SR-Madsen/CocktailMachine/DiscoveryDemo/TouchGFX/assets/images/download1-removebg-preview.png

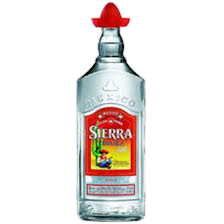
DiscoveryDemo/TouchGFX/assets/images/download1-removebg-preview.png
