SR-Madsen/CocktailMachine/DiscoveryDemo/TouchGFX/assets/images/download-removebg-preview.png

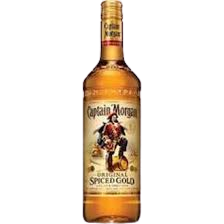
DiscoveryDemo/TouchGFX/assets/images/download-removebg-preview.png
