SR-Madsen/CocktailMachine/DiscoveryDemo/TouchGFX/assets/images/snapshotimagehandler_214572791-2-removebg-preview.png

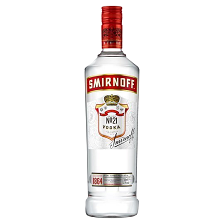
DiscoveryDemo/TouchGFX/assets/images/snapshotimagehandler_214572791-2-removebg-preview.png
