SR-Madsen/CocktailMachine/PCBV1/Powersupply.kicad_pcb

## KiCad design PCBV1/Powersupply.kicad_pcb (2021-08-30)

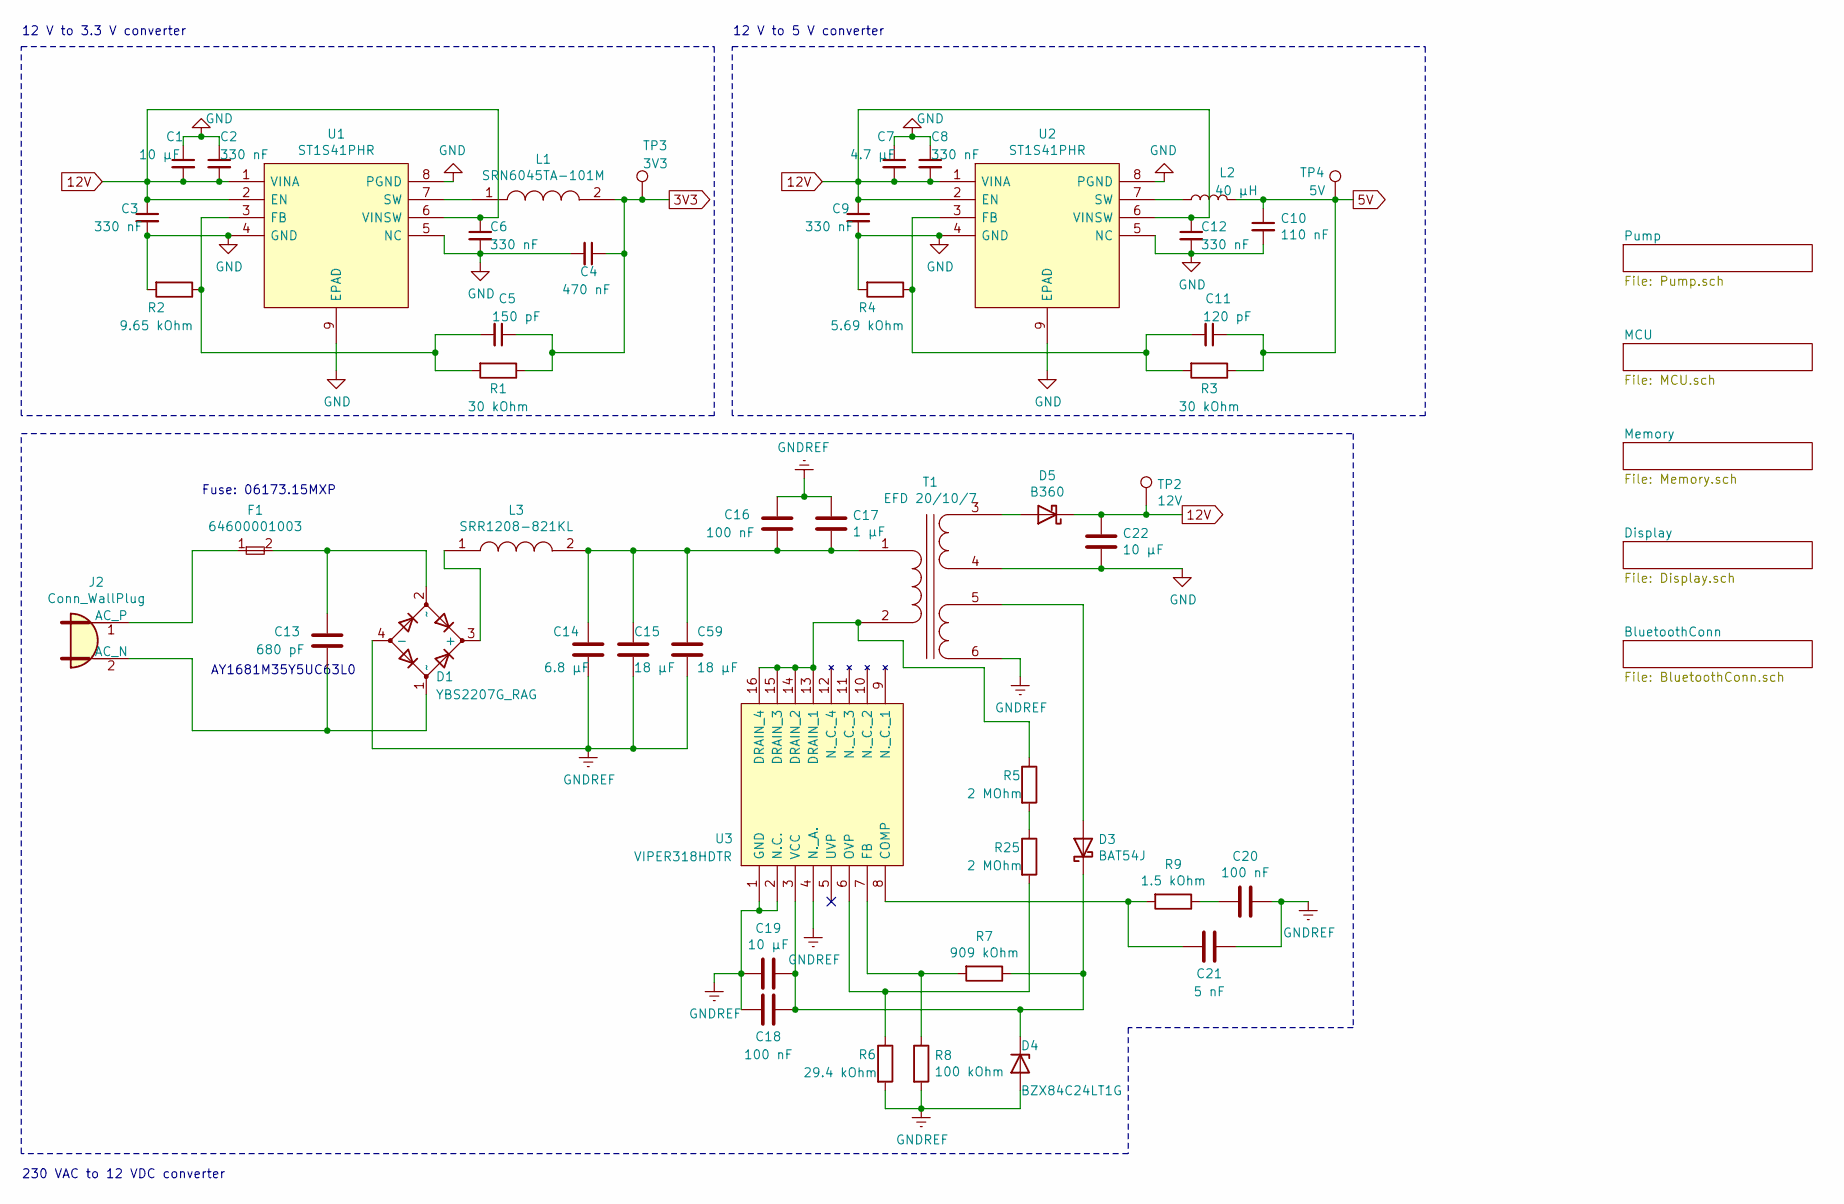
[picture p7: schematic Powersupply.sch, Cocktail Machine]

Parts:
C1, C19, C22: 10 µF; C_1206_3216Metric
C2, C3, C6, C8, C9, C12: 330 nF; C_0603_1608Metric
C4: 470 nF; C_0603_1608Metric
C5: 150 pF; C_0603_1608Metric
C7: 4.7 µF; C_0805_2012Metric
C10: 110 nF; C_0603_1608Metric
C11: 120 pF; C_0603_1608Metric
C13: 680 pF; C_Disc_D8.0mm_W5.0mm_P10.00mm
C14: 6.8 µF; CP_Radial_D10.0mm_P5.00mm
C15, C59: 18 µF; CP_Radial_D12.5mm_P5.00mm
C16: 100 nF; C_1210_3225Metric
C17: 1 µF; C_Rect_L24.0mm_W10.1mm_P22.50mm_MKT
C18, C20: 100 nF; C_0603_1608Metric
C21: 5 nF; C_0603_1608Metric
D1: YBS2207G_RAG; Mouser Part Number 821-YBS2207GRAG
D3: BAT54J; D_SOD-323F
D4: BZX84C24LT1G; D_SOT-23_ANK
D5: B360; D_SMC
F1: 64600001003; Mouser Part Number 576-64600001003
J2: Conn_WallPlug; PinHeader_1x02_P2.54mm_Vertical
L1: SRN6045TA-101M; Mouser Part Number 652-SRN6045TA-101M
L2: 40 µH; L_Bourns-SRN4018
L3: SRR1208-821KL; Mouser Part Number 652-SRR1208-821KL
R1, R3: 30 kOhm; R_0603_1608Metric
R2: 9.65 kOhm; R_0603_1608Metric
R4: 5.69 kOhm; R_0603_1608Metric
R5, R25: 2 MOhm; R_1206_3216Metric
R6: 29.4 kOhm; R_0603_1608Metric
R7: 909 kOhm; R_0603_1608Metric
R8: 100 kOhm; R_0603_1608Metric
R9: 1.5 kOhm; R_0603_1608Metric
T1: EFD 20/10/7; EFD_20_10_7
TP2: 12V; TestPoint_Pad_D2.0mm
TP3: 3V3; TestPoint_Pad_D2.0mm
TP4: 5V; TestPoint_Pad_D2.0mm
U1, U2: ST1S41PHR; Manufacturer_Part_Number ST1S41PHR
U3: VIPER318HDTR; Manufacturer_Part_Number VIPER318HDTR

Connections:
3V3: C4.1, C5.1, L1.2, R1.1, TP3.1; also elsewhere on the board
5V: C10.1, C11.1, L2.2, R3.1, TP4.1; also elsewhere on the board
12V: C1.2, C2.2, C3.1, C6.1, C7.2, C8.2, C9.1, C12.1, C22.1, D5.1 (K), TP2.1, U1.1 (VINA), U1.2 (EN), U1.6 (VINSW), U2.1 (VINA), U2.2 (EN), U2.6 (VINSW); also elsewhere on the board
GND: C1.1, C2.1, C3.2, C4.2, C6.2, C7.1, C8.1, C9.2, C10.2, C12.2, C22.2, R2.2, R4.2, T1.4 (SB), U1.4 (GND), U1.5 (NC), U1.8 (PGND), U1.9 (EPAD), U2.4 (GND), U2.5 (NC), U2.8 (PGND), U2.9 (EPAD); also elsewhere on the board
GNDREF: C14.2, C15.2, C16.1, C17.1, C18.2, C19.2, C20.1, C21.1, C59.2, D1.4 (-), D4.2 (A), R6.2, R8.2, T1.6 (SD), U3.1 (GND), U3.2 (N.C.), U3.4 (N._A.)
unnamed: C5.2, R1.2, R2.1, U1.3 (FB)
unnamed: C11.2, R3.2, R4.1, U2.3 (FB)
unnamed: C13.1, D1.2 (~~), F1.2
unnamed: C13.2, D1.1 (~~), J2.2 (AC_N)
unnamed: C14.1, C15.1, C16.2, C17.2, C59.1, L3.2, T1.1 (AA)
unnamed: C18.1, C19.1, D3.1 (K), D4.1 (K), R7.1, U3.3 (VCC)
unnamed: C20.2, R9.1
unnamed: C21.2, R9.2, U3.8 (COMP)
unnamed: D1.3 (+), L3.1
unnamed: D3.2 (A), T1.5 (SC)
unnamed: D5.2 (A), T1.3 (SA)
unnamed: F1.1, J2.1 (AC_P)
unnamed: L1.1, U1.7 (SW)
unnamed: L2.1, U2.7 (SW)
unnamed: R5.1, T1.2 (AB), U3.13 (DRAIN_1), U3.14 (DRAIN_2), U3.15 (DRAIN_3), U3.16 (DRAIN_4)
unnamed: R7.2, R8.1, U3.7 (FB)
unnamed: R5.2, R25.1
unnamed: R6.1, R25.2, U3.6 (OVP)

Notes on the sheet:
12 V to 3.3 V converter
12 V to 5 V converter
Fuse: 06173.15MXP
AY1681M35Y5UC63L0
230 VAC to 12 VDC converter

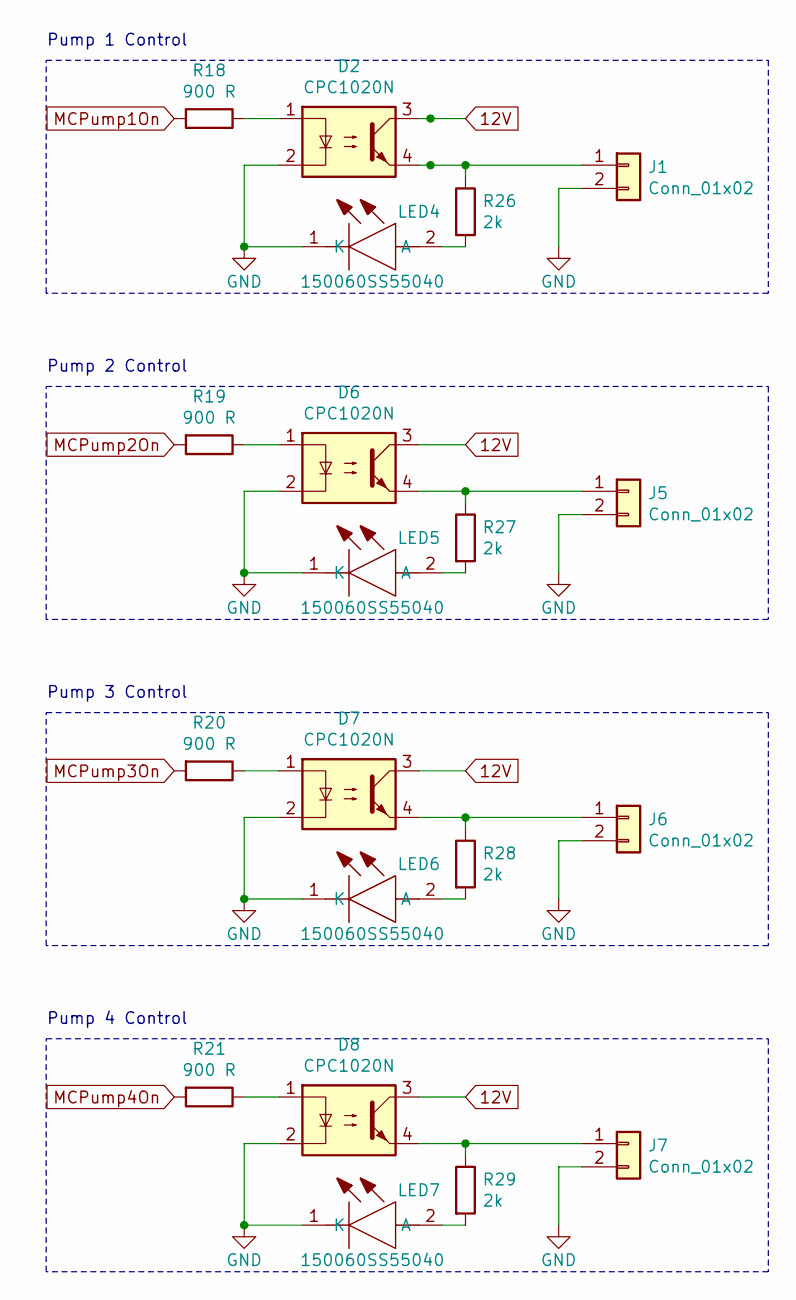
[picture p8: schematic Pump.sch, Cocktail Machine]

Parts:
D2, D6, D7, D8: CPC1020N; Mouser Part Number 849-CPC1020N
J1, J5, J6, J7: Conn_01x02; PinHeader_1x02_P2.54mm_Horizontal
LED4, LED5, LED6, LED7: 150060SS55040; Mouser Part Number 710-150060SS55040
R18, R19, R20, R21: 900 R; R_0603_1608Metric
R26, R27, R28, R29: 2k; R_0603_1608Metric

Connections:
12V: D2.3, D6.3, D7.3, D8.3; also elsewhere on the board
GND: D2.2, D6.2, D7.2, D8.2, J1.2, J5.2, J6.2, J7.2, LED4.1 (K), LED5.1 (K), LED6.1 (K), LED7.1 (K); also elsewhere on the board
MCPump1On: R18.2; also elsewhere on the board
MCPump2On: R19.2; also elsewhere on the board
MCPump3On: R20.2; also elsewhere on the board
MCPump4On: R21.2; also elsewhere on the board
unnamed: D2.1, R18.1
unnamed: D2.4, J1.1, R26.1
unnamed: D6.1, R19.1
unnamed: D6.4, J5.1, R27.1
unnamed: D7.1, R20.1
unnamed: D7.4, J6.1, R28.1
unnamed: D8.1, R21.1
unnamed: D8.4, J7.1, R29.1
unnamed: LED4.2 (A), R26.2
unnamed: LED5.2 (A), R27.2
unnamed: LED6.2 (A), R28.2
unnamed: LED7.2 (A), R29.2

Notes on the sheet:
Pump 1 Control
Pump 2 Control
Pump 3 Control
Pump 4 Control

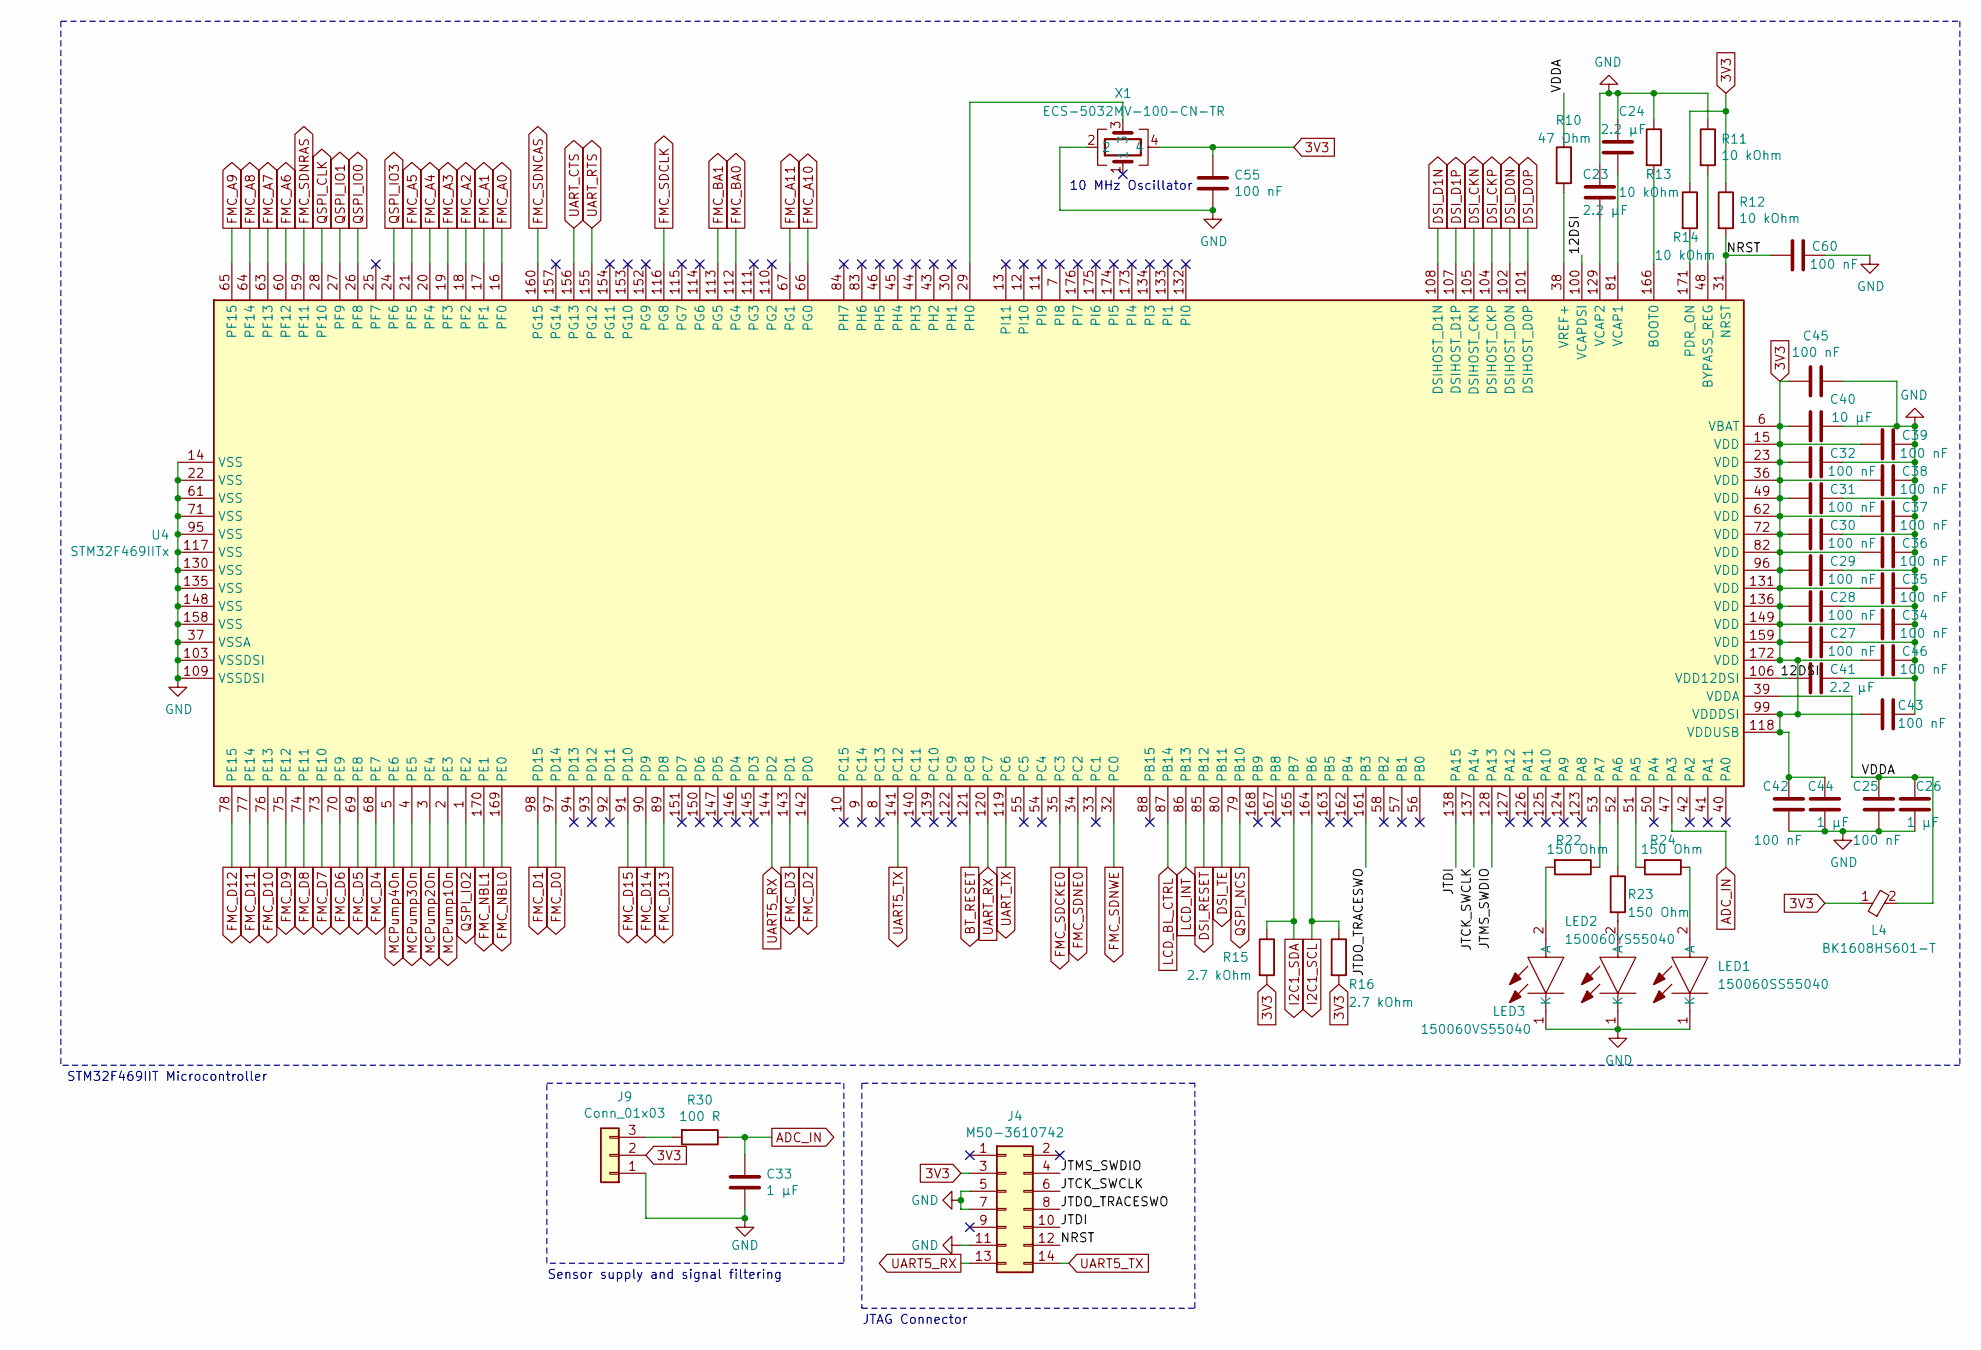
[picture p9: schematic MCU.sch, Cocktail Machine]

Parts:
C23, C24, C41: 2.2 µF; C_0603_1608Metric
C25, C27, C28, C29, C30, C31, C32, C34, C35, C36, C37, C38, C39, C42, C43, C45, C46, C55, C60: 100 nF; C_0603_1608Metric
C26, C33, C44: 1 µF; C_0603_1608Metric
C40: 10 µF; C_0603_1608Metric
J4: M50-3610742; M50-3610742R
J9: Conn_01x03; PinHeader_1x03_P2.54mm_Vertical
L4: BK1608HS601-T; Mouser Part Number 963-BK1608HS601-T
LED1: 150060SS55040; Mouser Part Number 710-150060SS55040
LED2: 150060YS55040; 150060VS55040; Mouser Part Number 710-150060YS55040
LED3: 150060VS55040; Mouser Part Number 710-150060VS55040
R10: 47 Ohm; R_0603_1608Metric
R11, R12, R13, R14: 10 kOhm; R_0603_1608Metric
R15, R16: 2.7 kOhm; R_0603_1608Metric
R22, R23, R24: 150 Ohm; R_0603_1608Metric
R30: 100 R; R_0603_1608Metric
U4: STM32F469IITx; LQFP-176_24x24mm_P0.5mm
X1: ECS-5032MV-100-CN-TR; ECS5032MV250CNTR; Mouser Part Number 520-5032MV-250-CNT

Connections:
3V3: C27.2, C28.2, C29.2, C30.2, C31.2, C32.2, C34.2, C35.2, C36.2, C37.2, C38.2, C39.2, C40.2, C42.1, C43.2, C44.1, C45.2, C46.1, C55.1, J4.3, J9.2, L4.1, R12.1, R14.1, R15.2, R16.2, U4.6 (VBAT), U4.15 (VDD), U4.23 (VDD), U4.36 (VDD), U4.49 (VDD), U4.62 (VDD), U4.72 (VDD), U4.82 (VDD), U4.96 (VDD), U4.99 (VDDDSI), U4.118 (VDDUSB), U4.131 (VDD), U4.136 (VDD), U4.149 (VDD), U4.159 (VDD), U4.172 (VDD), X1.4; also elsewhere on the board
/MCU/12DSI: C41.2, U4.100 (VCAPDSI), U4.106 (VDD12DSI)
/MCU/JTCK_SWCLK: J4.6, U4.137 (PA14)
/MCU/JTDI: J4.10, U4.138 (PA15)
/MCU/JTDO_TRACESWO: J4.8, U4.161 (PB3)
/MCU/JTMS_SWDIO: J4.4, U4.128 (PA13)
/MCU/NRST: C60.2, J4.12, R12.2, U4.31 (NRST)
/MCU/VDDA: C25.1, C26.1, L4.2, R10.1, U4.39 (VDDA)
ADC_IN: C33.1, R30.1, U4.47 (PA3)
BT_RESET: U4.121 (PC8); also elsewhere on the board
DSI_CKN: U4.105 (DSIHOST_CKN); also elsewhere on the board
DSI_CKP: U4.104 (DSIHOST_CKP); also elsewhere on the board
DSI_D0N: U4.102 (DSIHOST_D0N); also elsewhere on the board
DSI_D0P: U4.101 (DSIHOST_D0P); also elsewhere on the board
DSI_D1N: U4.108 (DSIHOST_D1N); also elsewhere on the board
DSI_D1P: U4.107 (DSIHOST_D1P); also elsewhere on the board
DSI_RESET: U4.85 (PB12); also elsewhere on the board
DSI_TE: U4.80 (PB11); also elsewhere on the board
FMC_A0: U4.16 (PF0); also elsewhere on the board
FMC_A1: U4.17 (PF1); also elsewhere on the board
FMC_A2: U4.18 (PF2); also elsewhere on the board
FMC_A3: U4.19 (PF3); also elsewhere on the board
FMC_A4: U4.20 (PF4); also elsewhere on the board
FMC_A5: U4.21 (PF5); also elsewhere on the board
FMC_A6: U4.60 (PF12); also elsewhere on the board
FMC_A7: U4.63 (PF13); also elsewhere on the board
FMC_A8: U4.64 (PF14); also elsewhere on the board
FMC_A9: U4.65 (PF15); also elsewhere on the board
FMC_A10: U4.66 (PG0); also elsewhere on the board
FMC_A11: U4.67 (PG1); also elsewhere on the board
FMC_BA0: U4.112 (PG4); also elsewhere on the board
FMC_BA1: U4.113 (PG5); also elsewhere on the board
FMC_D0: U4.97 (PD14); also elsewhere on the board
FMC_D1: U4.98 (PD15); also elsewhere on the board
FMC_D2: U4.142 (PD0); also elsewhere on the board
FMC_D3: U4.143 (PD1); also elsewhere on the board
FMC_D4: U4.68 (PE7); also elsewhere on the board
FMC_D5: U4.69 (PE8); also elsewhere on the board
FMC_D6: U4.70 (PE9); also elsewhere on the board
FMC_D7: U4.73 (PE10); also elsewhere on the board
FMC_D8: U4.74 (PE11); also elsewhere on the board
FMC_D9: U4.75 (PE12); also elsewhere on the board
FMC_D10: U4.76 (PE13); also elsewhere on the board
FMC_D11: U4.77 (PE14); also elsewhere on the board
FMC_D12: U4.78 (PE15); also elsewhere on the board
FMC_D13: U4.89 (PD8); also elsewhere on the board
FMC_D14: U4.90 (PD9); also elsewhere on the board
FMC_D15: U4.91 (PD10); also elsewhere on the board
FMC_NBL0: U4.169 (PE0); also elsewhere on the board
FMC_NBL1: U4.170 (PE1); also elsewhere on the board
FMC_SDCKE0: U4.35 (PC3); also elsewhere on the board
FMC_SDCLK: U4.116 (PG8); also elsewhere on the board
FMC_SDNCAS: U4.160 (PG15); also elsewhere on the board
FMC_SDNE0: U4.34 (PC2); also elsewhere on the board
FMC_SDNRAS: U4.59 (PF11); also elsewhere on the board
FMC_SDNWE: U4.32 (PC0); also elsewhere on the board
GND: C23.1, C24.1, C25.2, C26.2, C27.1, C28.1, C29.1, C30.1, C31.1, C32.1, C33.2, C34.1, C35.1, C36.1, C37.1, C38.1, C39.1, C40.1, C41.1, C42.2, C43.1, C44.2, C45.1, C46.2, C55.2, C60.1, J4.5, J4.7, J4.11, J9.1, LED1.1 (K), LED2.1 (K), LED3.1 (K), R11.1, R13.1, U4.14 (VSS), U4.22 (VSS), U4.37 (VSSA), U4.61 (VSS), U4.71 (VSS), U4.95 (VSS), U4.103 (VSSDSI), U4.109 (VSSDSI), U4.117 (VSS), U4.130 (VSS), U4.135 (VSS), U4.148 (VSS), U4.158 (VSS), X1.2; also elsewhere on the board
I2C1_SCL: R16.1, U4.164 (PB6); also elsewhere on the board
I2C1_SDA: R15.1, U4.165 (PB7); also elsewhere on the board
LCD_BL_CTRL: U4.87 (PB14); also elsewhere on the board
LCD_INT: U4.86 (PB13); also elsewhere on the board
MCPump1On: U4.2 (PE3); also elsewhere on the board
MCPump2On: U4.3 (PE4); also elsewhere on the board
MCPump3On: U4.4 (PE5); also elsewhere on the board
MCPump4On: U4.5 (PE6); also elsewhere on the board
unnamed: C23.2, U4.129 (VCAP2)
unnamed: C24.2, U4.81 (VCAP1)
unnamed: J9.3, R30.2
unnamed: LED1.2 (A), R24.1
unnamed: LED2.2 (A), R23.2
unnamed: LED3.2 (A), R22.2
unnamed: R10.2, U4.38 (VREF+)
unnamed: R11.2, U4.48 (BYPASS_REG)
unnamed: R13.2, U4.166 (BOOT0)
unnamed: R14.2, U4.171 (PDR_ON)
unnamed: R22.1, U4.53 (PA7)
unnamed: R23.1, U4.52 (PA6)
unnamed: R24.2, U4.51 (PA5)
unnamed: U4.29 (PH0), X1.3
QSPI_CLK: U4.28 (PF10); also elsewhere on the board
QSPI_IO0: U4.26 (PF8); also elsewhere on the board
QSPI_IO1: U4.27 (PF9); also elsewhere on the board
QSPI_IO2: U4.1 (PE2); also elsewhere on the board
QSPI_IO3: U4.24 (PF6); also elsewhere on the board
QSPI_NCS: U4.79 (PB10); also elsewhere on the board
UART5_RX: J4.13, U4.144 (PD2)
UART5_TX: J4.14, U4.141 (PC12)
UART_CTS: U4.156 (PG13); also elsewhere on the board
UART_RTS: U4.155 (PG12); also elsewhere on the board
UART_RX: U4.120 (PC7); also elsewhere on the board
UART_TX: U4.119 (PC6); also elsewhere on the board

Notes on the sheet:
JTAG Connector
STM32F469IIT Microcontroller
10 MHz Oscillator
Sensor supply and signal filtering

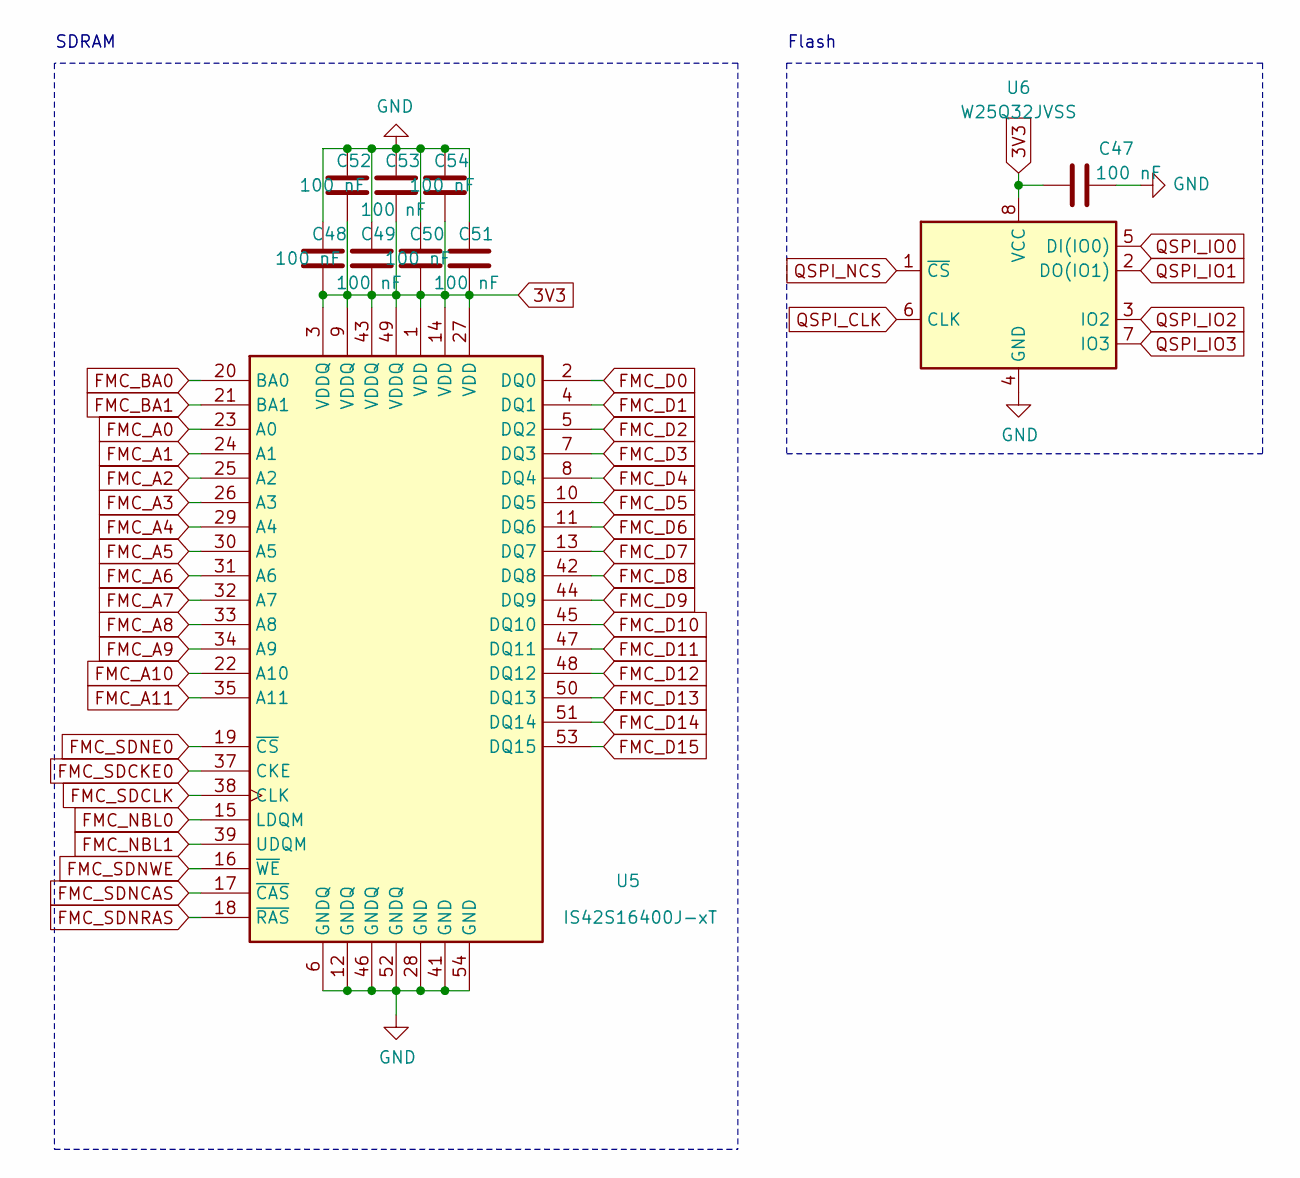
[picture p10: schematic Memory.sch, Cocktail Machine]

Parts:
C47, C48, C49, C50, C51, C52, C53, C54: 100 nF; C_0603_1608Metric
U5: IS42S16400J-xT; TSOP-II-54_22.2x10.16mm_P0.8mm
U6: W25Q32JVSS; SOIC-8_5.23x5.23mm_P1.27mm

Connections:
3V3: C47.2, C48.2, C49.2, C50.2, C51.2, C52.2, C53.2, C54.2, U5.1 (VDD), U5.3 (VDDQ), U5.9 (VDDQ), U5.14 (VDD), U5.27 (VDD), U5.43 (VDDQ), U5.49 (VDDQ), U6.8 (VCC); also elsewhere on the board
FMC_A0: U5.23 (A0); also elsewhere on the board
FMC_A1: U5.24 (A1); also elsewhere on the board
FMC_A2: U5.25 (A2); also elsewhere on the board
FMC_A3: U5.26 (A3); also elsewhere on the board
FMC_A4: U5.29 (A4); also elsewhere on the board
FMC_A5: U5.30 (A5); also elsewhere on the board
FMC_A6: U5.31 (A6); also elsewhere on the board
FMC_A7: U5.32 (A7); also elsewhere on the board
FMC_A8: U5.33 (A8); also elsewhere on the board
FMC_A9: U5.34 (A9); also elsewhere on the board
FMC_A10: U5.22 (A10); also elsewhere on the board
FMC_A11: U5.35 (A11); also elsewhere on the board
FMC_BA0: U5.20 (BA0); also elsewhere on the board
FMC_BA1: U5.21 (BA1); also elsewhere on the board
FMC_D0: U5.2 (DQ0); also elsewhere on the board
FMC_D1: U5.4 (DQ1); also elsewhere on the board
FMC_D2: U5.5 (DQ2); also elsewhere on the board
FMC_D3: U5.7 (DQ3); also elsewhere on the board
FMC_D4: U5.8 (DQ4); also elsewhere on the board
FMC_D5: U5.10 (DQ5); also elsewhere on the board
FMC_D6: U5.11 (DQ6); also elsewhere on the board
FMC_D7: U5.13 (DQ7); also elsewhere on the board
FMC_D8: U5.42 (DQ8); also elsewhere on the board
FMC_D9: U5.44 (DQ9); also elsewhere on the board
FMC_D10: U5.45 (DQ10); also elsewhere on the board
FMC_D11: U5.47 (DQ11); also elsewhere on the board
FMC_D12: U5.48 (DQ12); also elsewhere on the board
FMC_D13: U5.50 (DQ13); also elsewhere on the board
FMC_D14: U5.51 (DQ14); also elsewhere on the board
FMC_D15: U5.53 (DQ15); also elsewhere on the board
FMC_NBL0: U5.15 (LDQM); also elsewhere on the board
FMC_NBL1: U5.39 (UDQM); also elsewhere on the board
FMC_SDCKE0: U5.37 (CKE); also elsewhere on the board
FMC_SDCLK: U5.38 (CLK); also elsewhere on the board
FMC_SDNCAS: U5.17 (~CAS); also elsewhere on the board
FMC_SDNE0: U5.19 (~CS); also elsewhere on the board
FMC_SDNRAS: U5.18 (~RAS); also elsewhere on the board
FMC_SDNWE: U5.16 (~WE); also elsewhere on the board
GND: C47.1, C48.1, C49.1, C50.1, C51.1, C52.1, C53.1, C54.1, U5.6 (GNDQ), U5.12 (GNDQ), U5.28 (GND), U5.41 (GND), U5.46 (GNDQ), U5.52 (GNDQ), U5.54 (GND), U6.4 (GND); also elsewhere on the board
QSPI_CLK: U6.6 (CLK); also elsewhere on the board
QSPI_IO0: U6.5 (DI(IO0)); also elsewhere on the board
QSPI_IO1: U6.2 (DO(IO1)); also elsewhere on the board
QSPI_IO2: U6.3 (IO2); also elsewhere on the board
QSPI_IO3: U6.7 (IO3); also elsewhere on the board
QSPI_NCS: U6.1 (~CS); also elsewhere on the board

Notes on the sheet:
SDRAM
Flash

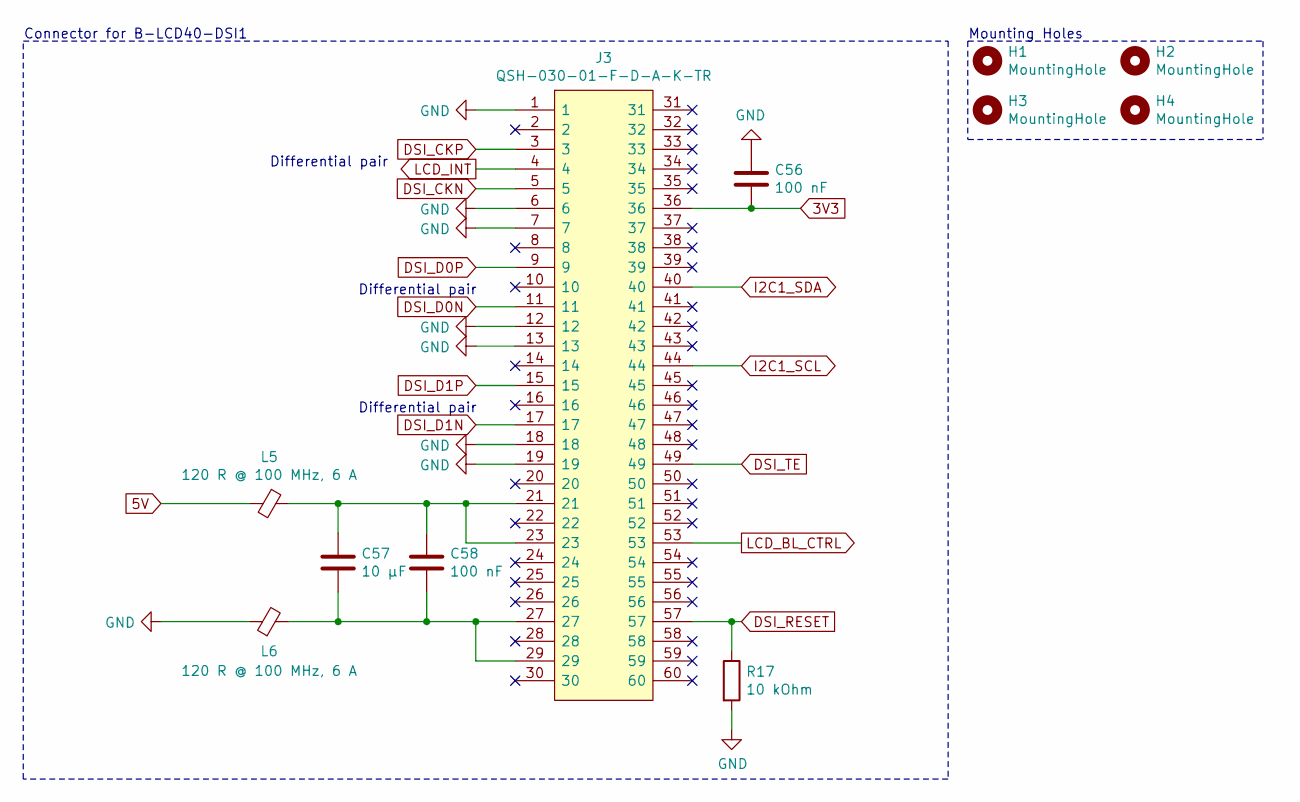
[picture p11: schematic Display.sch, Cocktail Machine]

Parts:
C56, C58: 100 nF; C_0603_1608Metric
C57: 10 µF; C_1206_3216Metric
H1, H2, H3, H4: MountingHole; MountingHole_6.4mm_M6_DIN965
J3: QSH-030-01-F-D-A-K-TR; QSH-030-01-F-D-A; Mouser Part Number 200-QSH03001FDAKTR
L5, L6: 120 R @ 100 MHz, 6 A; L_0805_2012Metric
R17: 10 kOhm; R_0603_1608Metric

Connections:
3V3: C56.2, J3.36; also elsewhere on the board
5V: L5.2; also elsewhere on the board
DSI_CKN: J3.5; also elsewhere on the board
DSI_CKP: J3.3; also elsewhere on the board
DSI_D0N: J3.11; also elsewhere on the board
DSI_D0P: J3.9; also elsewhere on the board
DSI_D1N: J3.17; also elsewhere on the board
DSI_D1P: J3.15; also elsewhere on the board
DSI_RESET: J3.57, R17.1; also elsewhere on the board
DSI_TE: J3.49; also elsewhere on the board
GND: C56.1, J3.1, J3.6, J3.7, J3.12, J3.13, J3.18, J3.19, L6.1, R17.2; also elsewhere on the board
I2C1_SCL: J3.44; also elsewhere on the board
I2C1_SDA: J3.40; also elsewhere on the board
LCD_BL_CTRL: J3.53; also elsewhere on the board
LCD_INT: J3.4; also elsewhere on the board
unnamed: C57.1, C58.1, J3.21, J3.23, L5.1
unnamed: C57.2, C58.2, J3.27, J3.29, L6.2

Notes on the sheet:
Connector for B-LCD40-DSI1
Mounting Holes
Differential pair

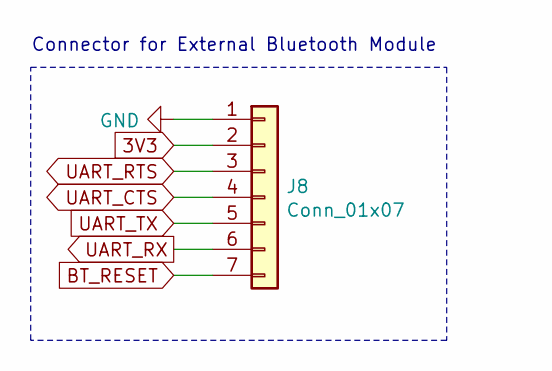
[picture p12: schematic BluetoothConn.sch, Cocktail Machine]

Parts:
J8: Conn_01x07; PinHeader_1x07_P2.54mm_Vertical

Connections:
3V3: J8.2; also elsewhere on the board
BT_RESET: J8.7; also elsewhere on the board
GND: J8.1; also elsewhere on the board
UART_CTS: J8.4; also elsewhere on the board
UART_RTS: J8.3; also elsewhere on the board
UART_RX: J8.6; also elsewhere on the board
UART_TX: J8.5; also elsewhere on the board

Notes on the sheet:
Connector for External Bluetooth Module

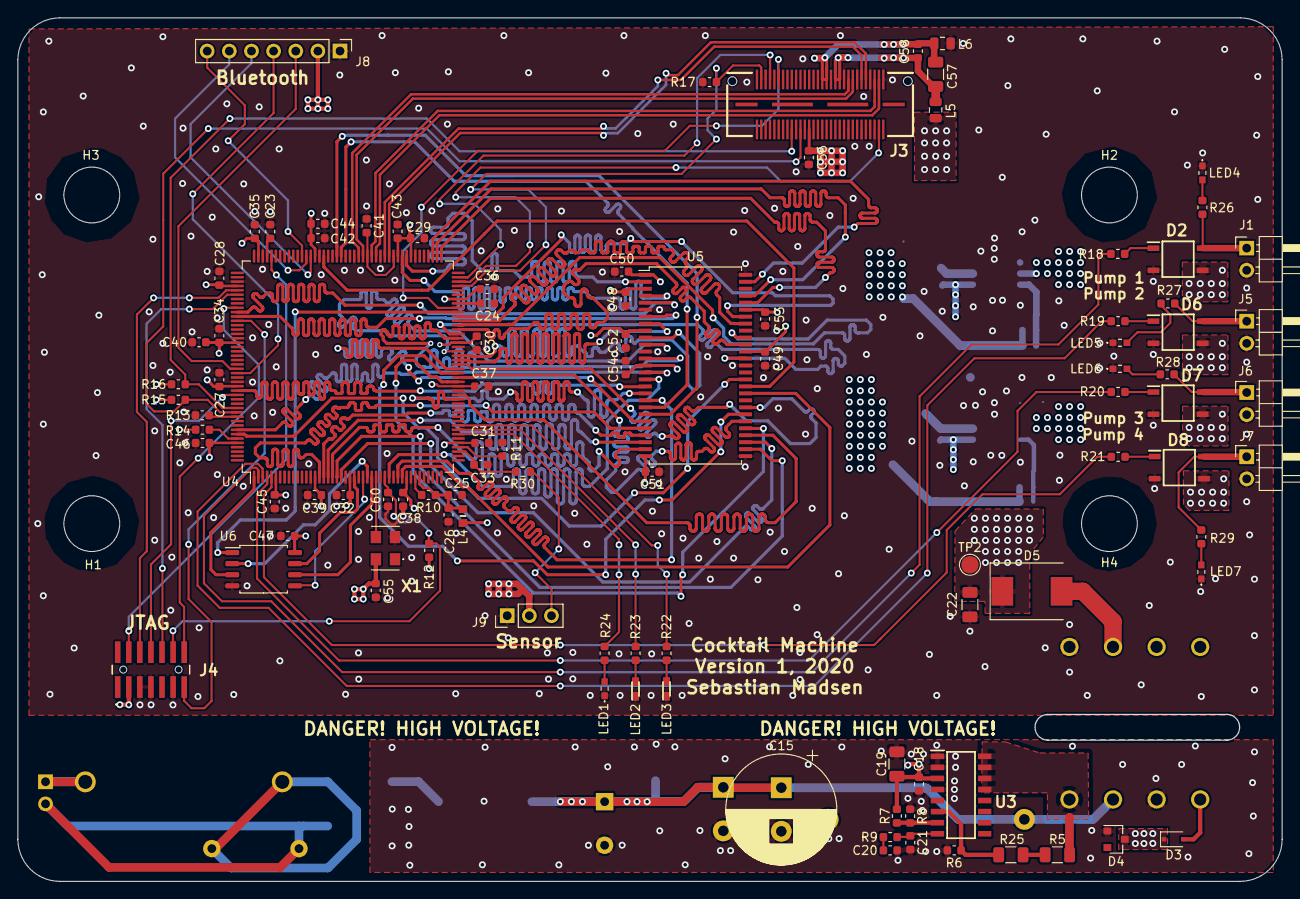
[picture p13: board Powersupply.kicad_pcb from above]

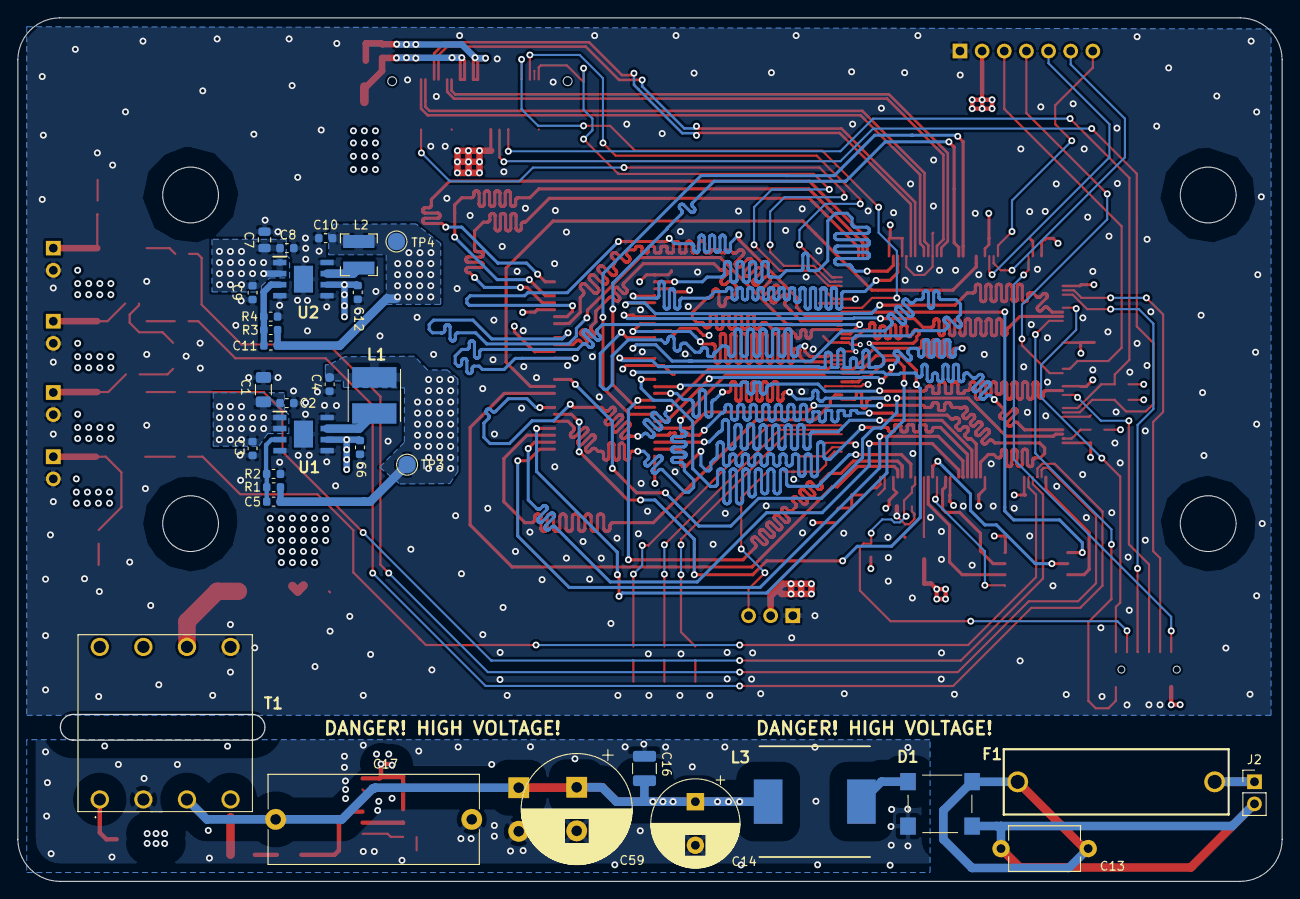
[picture p14: board Powersupply.kicad_pcb from below]

Board: 4 copper layers, 145.0 x 99.1 mm, 136 parts (32 on the bottom side), 126 nets.
