SR-Madsen/CocktailMachine/ConverterTest/ConverterTest.kicad_pcb

## KiCad design ConverterTest/ConverterTest.kicad_pcb (2020-10-31)

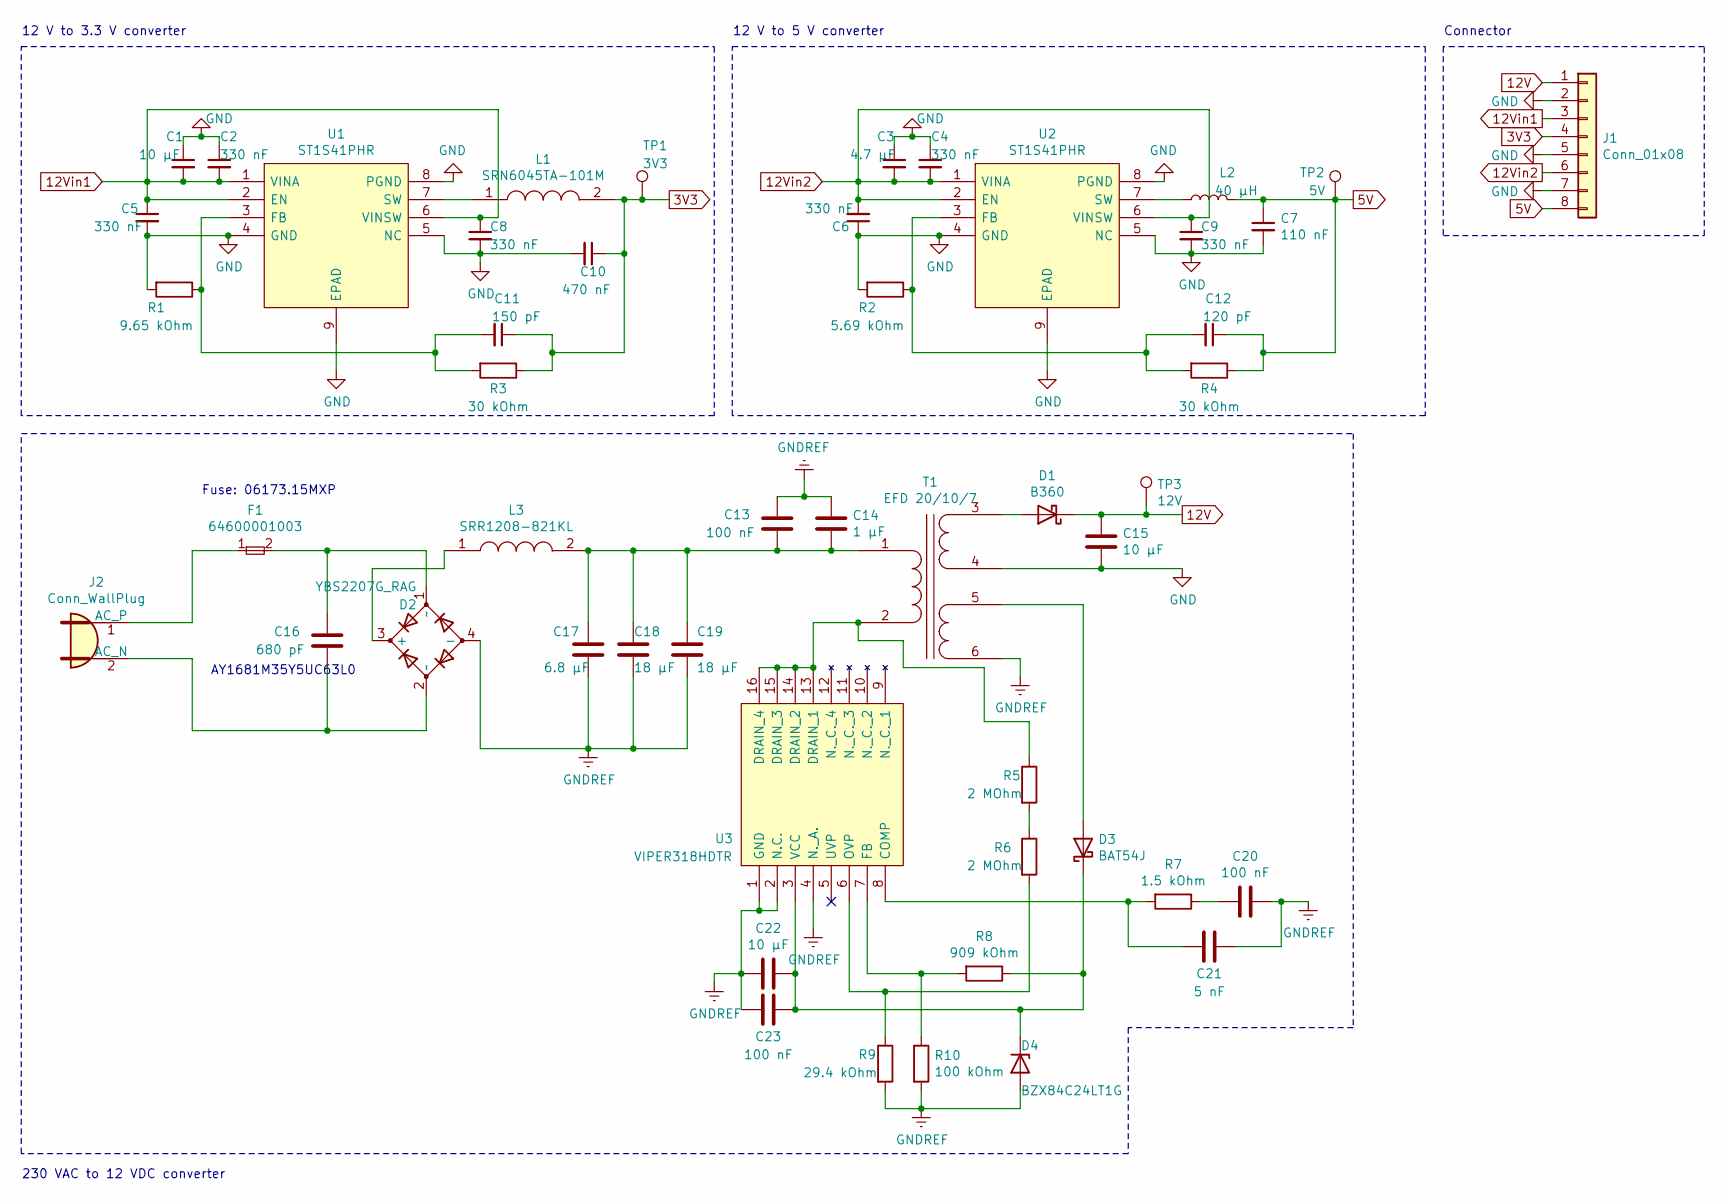
[picture p15: schematic ConverterTest.sch, Converter Tests]

Parts:
C1, C15, C22: 10 µF; C_1206_3216Metric
C2, C4, C5, C6, C8, C9: 330 nF; C_0603_1608Metric
C3: 4.7 µF; C_0805_2012Metric
C7: 110 nF; C_0603_1608Metric
C10: 470 nF; C_0603_1608Metric
C11: 150 pF; C_0603_1608Metric
C12: 120 pF; C_0603_1608Metric
C13: 100 nF; C_1210_3225Metric
C14: 1 µF; C_Rect_L24.0mm_W10.1mm_P22.50mm_MKT
C16: 680 pF; C_Disc_D8.0mm_W5.0mm_P10.00mm
C17: 6.8 µF; CP_Radial_D10.0mm_P5.00mm
C18, C19: 18 µF; CP_Radial_D12.5mm_P5.00mm
C20, C23: 100 nF; C_0603_1608Metric
C21: 5 nF; C_0603_1608Metric
D1: B360; D_SMC
D2: YBS2207G_RAG; Mouser Part Number 821-YBS2207GRAG
D3: BAT54J; D_SOD-323F
D4: BZX84C24LT1G; D_SOT-23_ANK
F1: 64600001003; Mouser Part Number 576-64600001003
J1: Conn_01x08; PinHeader_1x08_P2.54mm_Vertical
J2: Conn_WallPlug; PinHeader_1x02_P2.54mm_Vertical
L1: SRN6045TA-101M; Mouser Part Number 652-SRN6045TA-101M
L2: 40 µH; L_Bourns-SRN4018
L3: SRR1208-821KL; Mouser Part Number 652-SRR1208-821KL
R1: 9.65 kOhm; R_0603_1608Metric
R2: 5.69 kOhm; R_0603_1608Metric
R3, R4: 30 kOhm; R_0603_1608Metric
R5, R6: 2 MOhm; R_1206_3216Metric
R7: 1.5 kOhm; R_0603_1608Metric
R8: 909 kOhm; R_0603_1608Metric
R9: 29.4 kOhm; R_0603_1608Metric
R10: 100 kOhm; R_0603_1608Metric
T1: EFD 20/10/7; EFD_20_10_7
TP1: 3V3; TestPoint_Pad_D2.0mm
TP2: 5V; TestPoint_Pad_D2.0mm
TP3: 12V; TestPoint_Pad_D2.0mm
U1, U2: ST1S41PHR; Manufacturer_Part_Number ST1S41PHR
U3: VIPER318HDTR; Manufacturer_Part_Number VIPER318HDTR

Connections:
3V3: C10.1, C11.1, J1.4, L1.2, R3.1, TP1.1
5V: C7.1, C12.1, J1.8, L2.2, R4.1, TP2.1
12V: C15.1, D1.1 (K), J1.1, TP3.1
12Vin1: C1.2, C2.2, C5.1, C8.1, J1.3, U1.1 (VINA), U1.2 (EN), U1.6 (VINSW)
12Vin2: C3.2, C4.2, C6.2, C9.1, J1.6, U2.1 (VINA), U2.2 (EN), U2.6 (VINSW)
GND: C1.1, C2.1, C3.1, C4.1, C5.2, C6.1, C7.2, C8.2, C9.2, C10.2, C15.2, J1.2, J1.5, J1.7, R1.2, R2.2, T1.4 (SB), U1.4 (GND), U1.5 (NC), U1.8 (PGND), U1.9 (EPAD), U2.4 (GND), U2.5 (NC), U2.8 (PGND), U2.9 (EPAD)
GNDREF: C13.1, C14.1, C17.2, C18.2, C19.2, C20.1, C21.1, C22.2, C23.2, D2.4 (-), D4.2 (A), R9.2, R10.2, T1.6 (SD), U3.1 (GND), U3.2 (N.C.), U3.4 (N._A.)
unnamed: C11.2, R1.1, R3.2, U1.3 (FB)
unnamed: C12.2, R2.1, R4.2, U2.3 (FB)
unnamed: C13.2, C14.2, C17.1, C18.1, C19.1, L3.2, T1.1 (AA)
unnamed: C16.1, D2.1 (~~), F1.2
unnamed: C16.2, D2.2 (~~), J2.2 (AC_N)
unnamed: C20.2, R7.1
unnamed: C21.2, R7.2, U3.8 (COMP)
unnamed: C22.1, C23.1, D3.1 (K), D4.1 (K), R8.1, U3.3 (VCC)
unnamed: D1.2 (A), T1.3 (SA)
unnamed: D2.3 (+), L3.1
unnamed: D3.2 (A), T1.5 (SC)
unnamed: F1.1, J2.1 (AC_P)
unnamed: L1.1, U1.7 (SW)
unnamed: L2.1, U2.7 (SW)
unnamed: R5.1, T1.2 (AB), U3.13 (DRAIN_1), U3.14 (DRAIN_2), U3.15 (DRAIN_3), U3.16 (DRAIN_4)
unnamed: R5.2, R6.1
unnamed: R6.2, R9.1, U3.6 (OVP)
unnamed: R8.2, R10.1, U3.7 (FB)

Notes on the sheet:
12 V to 3.3 V converter
12 V to 5 V converter
Fuse: 06173.15MXP
AY1681M35Y5UC63L0
230 VAC to 12 VDC converter
Connector

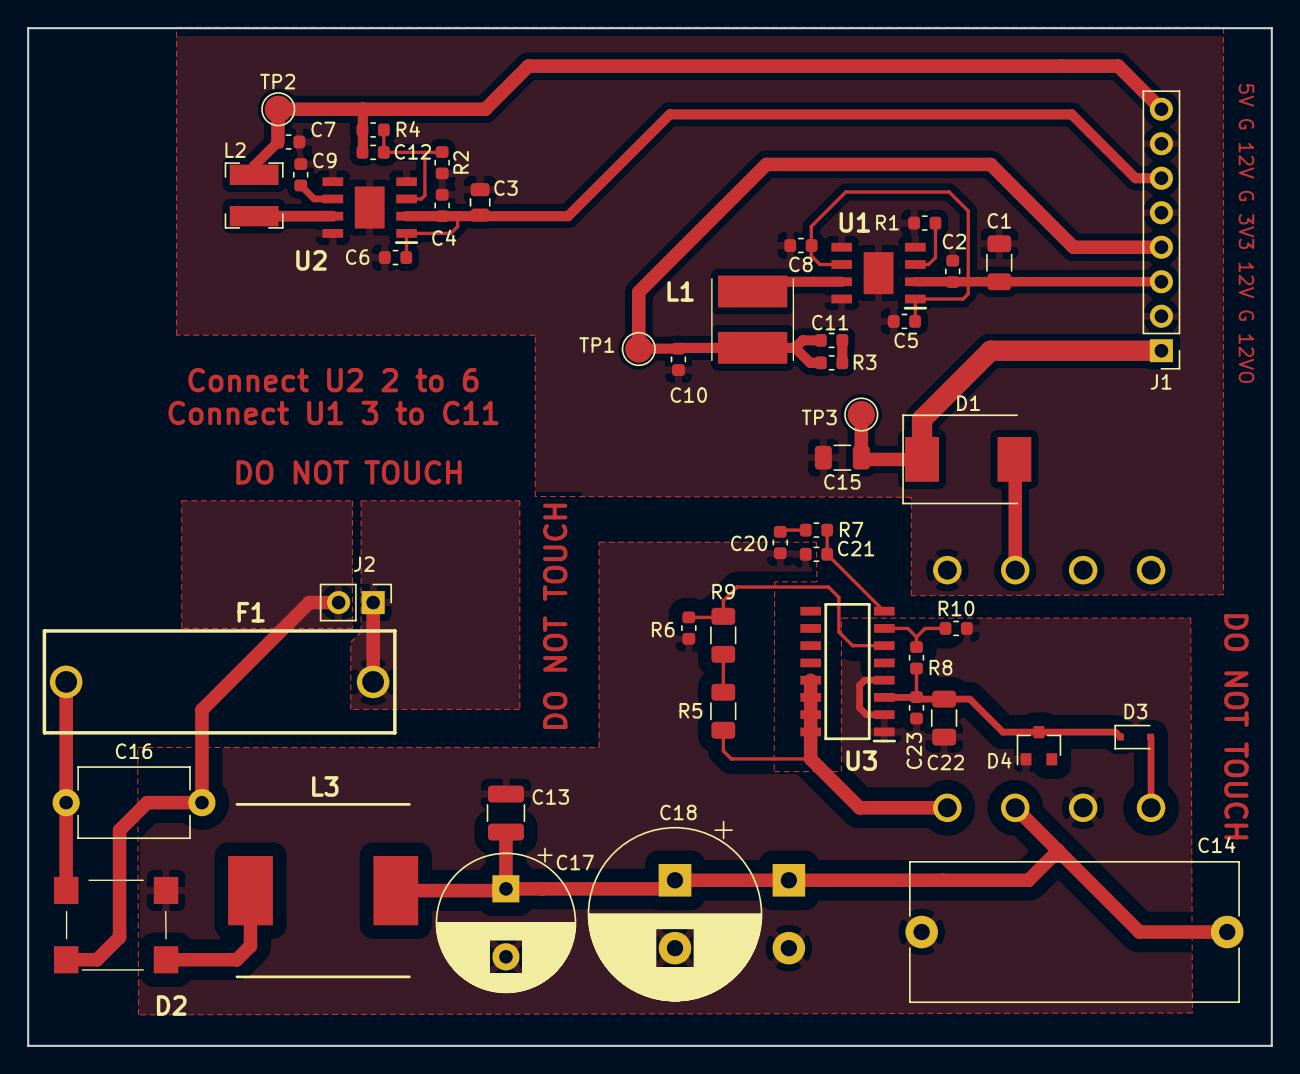
[picture p16: board ConverterTest.kicad_pcb from above]

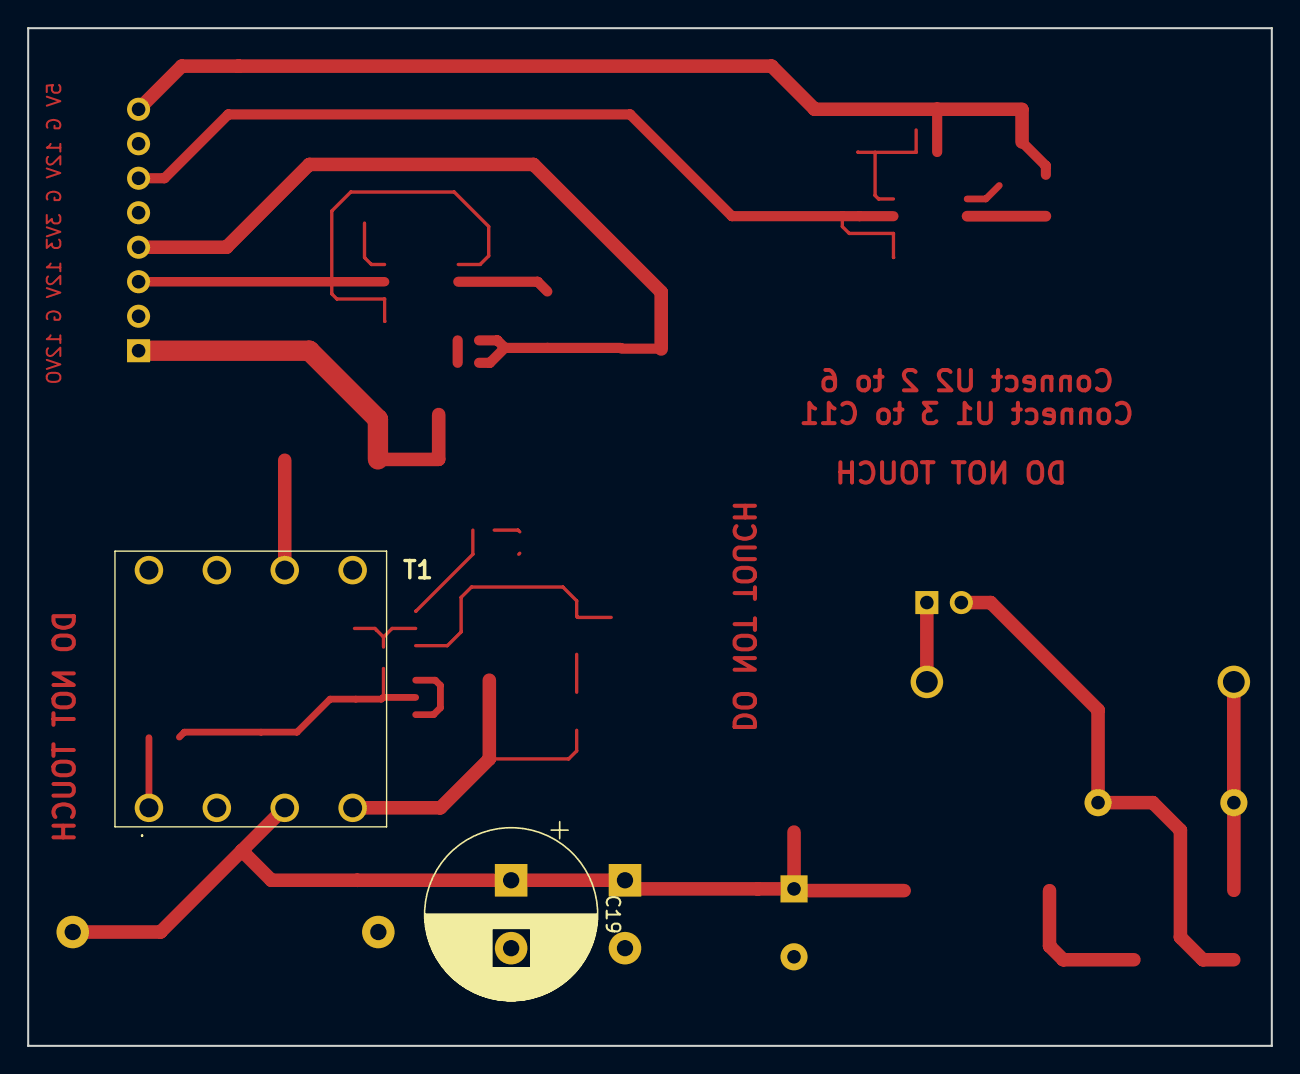
[picture p17: board ConverterTest.kicad_pcb from below]

Board: 2 copper layers, 91.6 x 74.9 mm, 50 parts (2 on the bottom side), 25 nets.
