SR-Madsen/CocktailMachine/Software/CocktailMachineF4.ioc

Mcu.UserName=STM32F469IITx
PA13.Signal=SYS_JTMS-SWDIO
PA14.Signal=SYS_JTCK-SWCLK
PA15.Signal=SYS_JTDI
PA3.Signal=ADCx_IN3
PA5.GPIO_Label=LED_RED
PA5.Signal=GPIO_Output
PA6.GPIO_Label=LED_YELLOW
PA6.Signal=GPIO_Output
PA7.GPIO_Label=LED_GREEN
PA7.Signal=GPIO_Output
PB10.Signal=QUADSPI_BK1_NCS
PB11.Signal=DSIHOST_TE
PB12.GPIO_Label=DSI_RESET
PB12.Signal=GPIO_Output
PB13.GPIO_Label=LCD_INT
PB13.Signal=GPIO_Input
PB14.GPIO_Label=LCD_BL_CTRL
PB14.Signal=GPIO_Input
PB3.Signal=SYS_JTDO-SWO
PB4.Signal=SYS_JTRST
PB6.Signal=I2C1_SCL
PB7.Signal=I2C1_SDA
PC0.Signal=FMC_SDNWE
PC12.Signal=UART5_TX
PC2.Signal=FMC_SDNE0
PC3.Signal=FMC_SDCKE0
PC8.GPIO_Label=BT_RESET
PC8.Signal=GPIO_Output
PD0.Signal=FMC_D2_DA2
PD1.Signal=FMC_D3_DA3
PD10.Signal=FMC_D15_DA15
PD14.Signal=FMC_D0_DA0
PD15.Signal=FMC_D1_DA1
PD2.Signal=UART5_RX
PD8.Signal=FMC_D13_DA13
PD9.Signal=FMC_D14_DA14
PE0.Signal=FMC_NBL0
PE1.Signal=FMC_NBL1
PE10.Signal=FMC_D7_DA7
PE11.Signal=FMC_D8_DA8
PE12.Signal=FMC_D9_DA9
PE13.Signal=FMC_D10_DA10
PE14.Signal=FMC_D11_DA11
PE15.Signal=FMC_D12_DA12
PE3.GPIO_Label=PUMP1_ON
PE3.Signal=GPIO_Output
PE4.GPIO_Label=PUMP2_ON
PE4.Signal=GPIO_Output
PE5.GPIO_Label=PUMP3_ON
PE5.Signal=GPIO_Output
PE6.GPIO_Label=PUMP4_ON
PE6.Signal=GPIO_Output
PE7.Signal=FMC_D4_DA4
PE8.Signal=FMC_D5_DA5
PE9.Signal=FMC_D6_DA6
PF0.Signal=FMC_A0
PF1.Signal=FMC_A1
PF10.Signal=QUADSPI_CLK
PF11.Signal=FMC_SDNRAS
PF12.Signal=FMC_A6
PF13.Signal=FMC_A7
PF14.Signal=FMC_A8
PF15.Signal=FMC_A9
PF2.Signal=FMC_A2
PF3.Signal=FMC_A3
PF4.Signal=FMC_A4
PF5.Signal=FMC_A5
PF6.Signal=QUADSPI_BK1_IO3
PF7.Signal=QUADSPI_BK1_IO2
PF8.Signal=QUADSPI_BK1_IO0
PF9.Signal=QUADSPI_BK1_IO1
PG0.Signal=FMC_A10
PG1.Signal=FMC_A11
PG15.Signal=FMC_SDNCAS
PG4.Signal=FMC_A14_BA0
PG5.Signal=FMC_A15_BA1
PG8.Signal=FMC_SDCLK
PH0/OSC_IN.Signal=RCC_OSC_IN
PH1/OSC_OUT.Signal=RCC_OSC_OUT
