SR-Madsen/CocktailMachine/Software/Core/Inc/main.h

#define PUMP1_ON_Pin GPIO_PIN_3
#define PUMP1_ON_GPIO_Port GPIOE
#define PUMP2_ON_Pin GPIO_PIN_4
#define PUMP2_ON_GPIO_Port GPIOE
#define PUMP3_ON_Pin GPIO_PIN_5
#define PUMP3_ON_GPIO_Port GPIOE
#define PUMP4_ON_Pin GPIO_PIN_6
#define PUMP4_ON_GPIO_Port GPIOE
#define LED_RED_Pin GPIO_PIN_5
#define LED_RED_GPIO_Port GPIOA
#define LED_YELLOW_Pin GPIO_PIN_6
#define LED_YELLOW_GPIO_Port GPIOA
#define LED_GREEN_Pin GPIO_PIN_7
#define LED_GREEN_GPIO_Port GPIOA
#define DSI_RESET_Pin GPIO_PIN_12
#define DSI_RESET_GPIO_Port GPIOB
#define LCD_INT_Pin GPIO_PIN_13
#define LCD_INT_GPIO_Port GPIOB
#define LCD_BL_CTRL_Pin GPIO_PIN_14
#define LCD_BL_CTRL_GPIO_Port GPIOB
#define BT_RESET_Pin GPIO_PIN_8
#define BT_RESET_GPIO_Port GPIOC
