SR-Madsen/CocktailMachine/(commit log)

2020-09-16 Added STM32CubeMX configuration file.
2020-10-24 Added finished PCB for project. Requires review.
    [BluetoothConn.sch, CPC1020N.stp, Display.sch, MCU.sch, Memory.sch, Powersupply.kicad_pcb, Powersupply.sch, Pump.sch]
2020-10-25 Changed ferrite beads to ones with adequate max currents. Changed JTAG connector to 20-pin standard. Minor PCB fixes.
    [Display.sch, MCU.sch, Powersupply.kicad_pcb]
2020-10-26 Made changes to PCB (added many planes/polygons instead of traces, increased amount of vias, increased trace sizes).
    [Powersupply.kicad_pcb]
2020-10-31 Added new JTAG/UART header with connections for STLink V3. Moved from SamacSys to personal GitHub-based library.
    [CPC1020N.stp, Display.sch, MCU.sch, Powersupply.kicad_pcb, Powersupply.sch, Pump.sch, ST1S41PHR.stl, ST1S41PHR.stp]
2020-10-31 Fixed error made during STM32CubeMX configuration.
    [CocktailMachineF4.ioc]
2020-10-31 Updated schematic descriptions. Added converter test PCB.
    [BluetoothConn.sch, ConverterTest.kicad_pcb, ConverterTest.sch, Display.sch, MCU.sch, Memory.sch, Powersupply.kicad_pcb, Powersupply.sch]
2020-10-31 Fixed FMC related error in MX file and added ADC pin. Added connector and filter for external sensor.
    [MCU.sch, Powersupply.kicad_pcb]
2020-10-31 Forgot to save before commit.
    [Powersupply.kicad_pcb]
2020-11-01 Final fixes to PCB silk screen and via layout.
    [Powersupply.kicad_pcb]
2020-11-01 Alterations to voltage regulator circuits for improved performance.
    [Powersupply.kicad_pcb]
2020-11-02 Added isolation air gap to transformer.
    [Powersupply.kicad_pcb]
2020-11-23 Very minor changes to layout to make it prettier.
    [Powersupply.kicad_pcb]
2020-11-24 Added silk screen text.
    [Powersupply.kicad_pcb]
2020-11-27 Prettified the PCB, minor changes to routing.
    [Powersupply.kicad_pcb]
2020-11-30 Minor changes to CubeMX. Generated code for IDE, added TouchGFX GUI and code. Begun work on board bring-up code.
    [texts.xlsx]
2020-12-06 Further work on implementing all drivers. LCD drivers have been implemented. Flash loader is up next, as well as AL.
2021-01-09 Removed guard ring from crystal.
    [Powersupply.kicad_pcb]
2021-08-16 Updated and added working demo. Restarted TouchGFX project.
    [texts.xlsx]
2021-08-30 Rebuilt project for better folder structure. Started work on peripheral drivers (BSP) and HAL.
    [Powersupply.kicad_pcb]
